mcfitz2/RoadNode/hardware/carrier/fab/lcsc_handfit.csv

LCSC Part Number | Quantity | Comment | Designator
C144395 | 3 | OBD pigtail | J1
C15771 | 3 | PESD1CAN | D4
C2905422 | 5 | Heltec JP4 | J4,J5
C2937110 | 3 | 1.5A hold | F1
C408468 | 3 | 15u | L1
C50950 | 3 | GT-U7 | J2
C53055672 | 3 | TERM 120R | JP1
C100114 | 3 | 2.54 mm jumper shunt | JP1 shunt
