mcfitz2/RoadNode/hardware/carrier/carrier.kicad_pcb

## KiCad design hardware/carrier/carrier.kicad_pcb (2026-10-16)

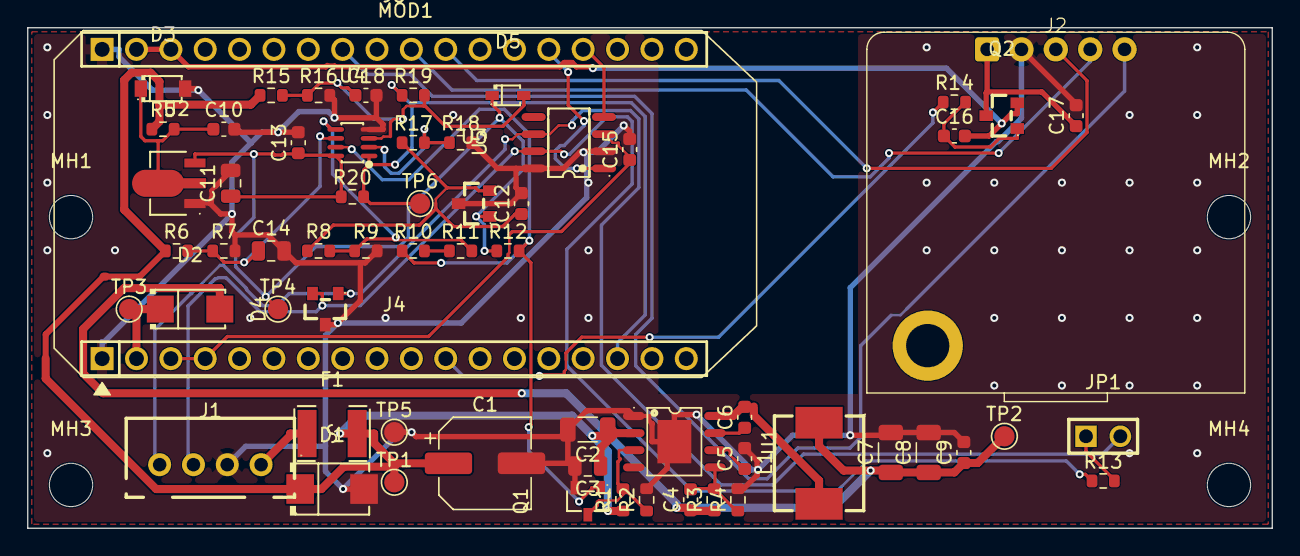
[picture p1: board carrier.kicad_pcb from above]

Board: 2 copper layers, 92.0 x 37.0 mm, 68 parts (0 on the bottom side), 33 nets.

Parts:
C1: 47u 50V; CP_Elec_6.3x7.7
C2: 10u 50V; C_1206_3216Metric
C3: 100n 100V; C_0805_2012Metric
C4: 10p C0G; C_0603_1608Metric
C5, C10, C17: 1u; C_0603_1608Metric
C6, C9, C12, C13, C15, C18: 100n; C_0603_1608Metric
C7, C8: 22u 25V; C_1206_3216Metric
C11, C14: 10u; C_0805_2012Metric
C16: 10n; C_0603_1608Metric
D1: SMBJ26A; SMB_L4.6-W3.6-LS5.3-RD
D2: SS34; SMA_L4.3-W2.6-LS5.2-RD
D3: BZT52C24; SOD-123_L2.7-W1.6-LS3.7-RD
D4: PESD1CAN; SOT-23_L2.9-W1.3-P1.90-LS2.4-BR
D5: 1N4148WS; SOD-323_L1.8-W1.3-LS2.5-RD
F1: 1.5A hold; F1812
J1: OBD pigtail; CONN-TH_B4B-XH-A-LF-SN
J2: GT-U7; GT-U7_THT
J4: Heltec JP4; HDR-TH_18P-P2.54-V-F
J5: Heltec JP5; HDR-TH_18P-P2.54-V-F
JP1: TERM 120R; HDR-TH_2P-P2.54-V-M_2
L1: 15u; IND-SMD_L7.3-W6.8
MH1, MH2, MH3, MH4: M3; MountingHole_3.2mm_M3
MOD1: Heltec WiFi LoRa 32 V4.3 (on sockets); Heltec_WiFi_LoRa32_V4
Q1: 2N7002; SOT-23-3_L2.9-W1.3-P1.90-LS2.4-BR
Q2: AO3401A; SOT-23_L2.9-W1.3-P1.90-LS2.4-BR
R1, R6: 3M; R_0603_1608Metric
R2, R7, R18: 750k; R_0603_1608Metric
R3, R12, R15, R20: 1M; R_0603_1608Metric
R4: 240k; R_0603_1608Metric
R5, R14: 10k; R_0603_1608Metric
R8: 510k; R_0603_1608Metric
R9, R10, R11, R19: 10M; R_0603_1608Metric
R13: 120; R_0603_1608Metric
R16: 220k; R_0603_1608Metric
R17: 47k; R_0603_1608Metric
TP1: VIN; TestPoint_Pad_D1.5mm
TP2: V5R; TestPoint_Pad_D1.5mm
TP3: H5V; TestPoint_Pad_D1.5mm
TP4: V3A; TestPoint_Pad_D1.5mm
TP5: GND; TestPoint_Pad_D1.5mm
TP6: WAKE; TestPoint_Pad_D1.5mm
U1: LMR36520ADDAR; POWERPAD-SO-8_L4.9-W3.9-P1.27-LS6.0-BL-EP
U2: HT7533-1; SOT-89-3_L4.5-W2.5-P1.50-LS4.2-BR
U3: REF3325 2.5V; SOT-23_L2.9-W1.3-P1.90-LS2.4-BR
U4: TLV7022DDFR; SOT-23-8_L2.9-W1.6-P0.65-LS2.8-BR
U5: SN65HVD230DR; SOIC-8_L4.9-W3.9-P1.27-LS6.0-BL

Connections:
3V3: C16.2, J5.2, J5.3, Q2.2
BOOT: C6.1, U1.7
BUCK_VCC: C5.1, U1.6
CANH: D4.2, J1.3, R13.1, U5.7
CANL: D4.1, J1.4, JP1.2, U5.6
CAN_RX: J5.15, U5.4
CAN_TERM: JP1.1, R13.2
CAN_TX: J5.14, U5.1
CAR_ON: J4.16, R19.1, R20.2, TP6.1, U4.1
EN: Q1.3, R1.2, R2.1, U1.3
FB: C4.2, R3.2, R4.1, U1.5
GND: C1.2, C2.2, C3.2, C5.2, C7.2, C8.2, C9.2, C10.2, C11.2, C12.2, C13.2, C14.2, C15.2, C17.2, C18.2, D1.2, D3.2, D4.3, J1.2, J2.2, J4.1, J5.1, Q1.2, R2.2, R4.2, R7.2, R9.2, R16.2, R18.2, TP5.1, U1.1, U1.9, U2.1, U3.3, U4.4, U5.2, U5.8
GNSS_EN_N: J4.11, R14.1
GNSS_G: C16.1, Q2.1, R14.2
GNSS_VCC: C17.1, J2.1, Q2.3
GPS_PPS: J2.5, J5.8
GPS_RXD: J2.3, J5.11
GPS_TXD: J2.4, J5.10
H_5V: D2.1, J4.2, TP3.1
SW: C6.2, L1.1, U1.8
UV_HYS: R10.2, R11.1
UV_LOW: Q1.1, R10.1, R12.2, U4.7
UV_REF: R8.2, R9.1, R11.2, U4.5
UV_TAP: C14.1, R6.2, R7.1, U4.6
V3A: C11.1, C13.1, D5.1, R12.1, R20.1, TP4.1, U2.3, U3.1, U4.8
V3A_IN: C10.1, D3.1, R5.2, U2.2
V5R: C4.1, C7.1, C8.1, C9.1, D2.2, L1.2, R3.1, TP2.1
VEXT: C15.1, J4.3, J4.4, U5.3
VIN: C1.1, C2.1, C3.1, D1.1, F1.2, R1.1, R5.1, R6.1, R15.1, TP1.1, U1.2
VREF: C12.1, R8.1, R17.1, U3.2
V_CAR: F1.1, J1.1
V_TAP: C18.1, D5.2, R15.2, R16.1, R19.2, U4.3
WAKE_REF: R17.2, R18.1, U4.2
