mcfitz2/RoadNode/src/vehicle/vehicle_state.h

#pragma once

#include <stddef.h>
#include <stdint.h>
#include <string.h>

#ifdef ARDUINO
#include "freertos/FreeRTOS.h"
#include "freertos/semphr.h"
#else
#include <mutex>
#endif

// Output-agnostic vehicle state (plan section 15). No MeshCore dependency:
// telemetry, serial output and any future UI all read from here.
namespace roadnode {
namespace vehicle {

enum DtcKind : uint8_t { DTC_STORED = 1, DTC_PENDING = 2, DTC_PERMANENT = 3 };

struct VehicleSnapshot {
  char vehicle_id[16] = {0};

  uint64_t total_mm = 0;
  uint64_t trip_mm = 0;
  bool trip_active = false;

  // Each live value is valid only if its has_* flag is set (never assume zero).
  bool has_speed = false;
  float speed_kmh = 0;
  bool has_rpm = false;
  float rpm = 0;
  bool has_battery = false;
  float battery_v = 0;

  // Slow-changing engine values (polled one PID at a time, see PollerConfig).
  bool has_coolant = false;
  float coolant_c = 0;
  bool has_load = false;
  float load_pct = 0;
  bool has_intake = false;
  float intake_c = 0;
  bool has_fuel = false;
  float fuel_pct = 0;

  // Last successful DTC read (modes 03/07/0A merged). Kept while OBD is briefly
  // lost; has_dtcs stays false until the first successful read.
  static constexpr size_t MAX_DTCS = 12;
  bool has_dtcs = false;
  uint16_t dtc_total = 0;          // codes the ECU reported, may exceed MAX_DTCS
  uint8_t dtc_count = 0;           // entries filled below
  uint16_t dtc_raw[MAX_DTCS] = {0};
  uint8_t dtc_kind[MAX_DTCS] = {0};  // DTC_STORED/PENDING/PERMANENT

  bool vehicle_active = false;  // CAN bus traffic seen recently
  bool engine_running = false;
  bool obd_connected = false;   // ECU answering requests

  // Milliseconds on the node's clock; 0 with the matching ever_* flag clear = never.
  bool ever_can_activity = false;
  uint32_t last_can_activity_ms = 0;
  bool ever_obd_response = false;
  uint32_t last_obd_response_ms = 0;
};

// Single writer (OBD poller) publishes complete snapshots; any number of
// readers copy them. Readers never see a half-updated snapshot.
class VehicleTelemetry {
public:
  VehicleTelemetry() {
#ifdef ARDUINO
    _mutex = xSemaphoreCreateMutex();
#endif
  }
  VehicleTelemetry(const VehicleTelemetry&) = delete;
  VehicleTelemetry& operator=(const VehicleTelemetry&) = delete;

  void publish(const VehicleSnapshot& s) {
    lock();
    _snap = s;
    unlock();
  }

  VehicleSnapshot snapshot() const {
    lock();
    VehicleSnapshot copy = _snap;
    unlock();
    return copy;
  }

private:
#ifdef ARDUINO
  void lock() const { xSemaphoreTake(_mutex, portMAX_DELAY); }
  void unlock() const { xSemaphoreGive(_mutex); }
  SemaphoreHandle_t _mutex;
#else
  void lock() const { _mutex.lock(); }
  void unlock() const { _mutex.unlock(); }
  mutable std::mutex _mutex;
#endif
  VehicleSnapshot _snap;
};

}  // namespace vehicle
}  // namespace roadnode
