mcfitz2/RoadNode/src/telemetry/vehicle_lpp.h

#pragma once

#include <stddef.h>
#include <stdint.h>

#include "vehicle/vehicle_state.h"

// Vehicle telemetry as Cayenne LPP (spec: docs/telemetry.md, issue #31).
// Header-only and templated on the LPP writer, so it has no MeshCore or
// CayenneLPP dependency: firmware instantiates it with CayenneLPP, host tests
// with a model of the wire format. Location is deliberately never encoded (#51).
namespace roadnode {
namespace telemetry {

// Channel 1 is MeshCore's own (device battery, GPS). Vehicle data starts at 2.
constexpr uint8_t CH_TOTAL_DISTANCE = 2;   // LPP generic sensor, units of 0.1 km
constexpr uint8_t CH_TRIP_DISTANCE = 3;    // LPP distance, metres
constexpr uint8_t CH_SPEED = 4;            // LPP analog input, km/h
constexpr uint8_t CH_STATE = 6;            // LPP digital input, bit flags
constexpr uint8_t CH_VEHICLE_BATTERY = 7;  // LPP voltage, volts
// VIN: 17 characters, 6 bits each, 4 per LPP generic sensor (24 bits, exact
// through a float). Channels 18-22; 8-17 were retired in PROJ-680.
constexpr uint8_t CH_VIN_FIRST = 18;
constexpr uint8_t VIN_CHANNELS = 5;

constexpr uint8_t STATE_VEHICLE_ACTIVE = 1 << 0;
constexpr uint8_t STATE_ENGINE_RUNNING = 1 << 1;
constexpr uint8_t STATE_TRIP_ACTIVE = 1 << 2;
constexpr uint8_t STATE_OBD_CONNECTED = 1 << 3;

// LPP encodes value * multiplier into a uint32 from a float. A float holds
// integers exactly up to 2^24, so the total is capped there (1.6 million km).
constexpr uint32_t TOTAL_UNIT_MM = 100000;
constexpr uint32_t TOTAL_MAX_UNITS = 16777216;
// LPP distance is 0.001 m in 32 bits: 4,294,967 m. Stay under it.
constexpr uint32_t TRIP_MAX_M = 4294000;

// VIN character codes: 0 = none, '0'-'9' = 1-10, 'A'-'Z' = 11-36.
inline uint32_t vinCharCode(char c) {
  if (c >= '0' && c <= '9') return (uint32_t)(c - '0') + 1;
  if (c >= 'A' && c <= 'Z') return (uint32_t)(c - 'A') + 11;
  return 0;
}

inline char vinCodeChar(uint32_t code) {
  if (code >= 1 && code <= 10) return (char)('0' + code - 1);
  if (code >= 11 && code <= 36) return (char)('A' + code - 11);
  return 0;
}

// Packs a 17-character VIN into VIN_CHANNELS 24-bit values, first character in
// the high bits. False (nothing written) if the VIN is missing or not 0-9/A-Z.
inline bool packVin(const char* vin, uint32_t out[VIN_CHANNELS]) {
  for (int g = 0; g < VIN_CHANNELS; g++) out[g] = 0;
  for (int i = 0; i < 17; i++) {
    uint32_t code = vinCharCode(vin[i]);
    if (code == 0) return false;
    out[i / 4] |= code << (18 - 6 * (i % 4));
  }
  return vin[17] == 0;
}

// Fields without a fresh value are omitted, never sent as zero. Total, trip
// and state are always present; the VIN only once one has been read.
template <class Lpp>
void encodeVehicle(const vehicle::VehicleSnapshot& s, Lpp& lpp) {
  uint64_t units = s.total_mm / TOTAL_UNIT_MM;
  if (units > TOTAL_MAX_UNITS) units = TOTAL_MAX_UNITS;
  lpp.addGenericSensor(CH_TOTAL_DISTANCE, (float)units);

  float trip_m = (float)(s.trip_mm / 1000.0);
  if (trip_m > (float)TRIP_MAX_M) trip_m = (float)TRIP_MAX_M;
  lpp.addDistance(CH_TRIP_DISTANCE, trip_m);

  if (s.has_speed) lpp.addAnalogInput(CH_SPEED, s.speed_kmh);

  uint8_t state = 0;
  if (s.vehicle_active) state |= STATE_VEHICLE_ACTIVE;
  if (s.engine_running) state |= STATE_ENGINE_RUNNING;
  if (s.trip_active) state |= STATE_TRIP_ACTIVE;
  if (s.obd_connected) state |= STATE_OBD_CONNECTED;
  lpp.addDigitalInput(CH_STATE, state);

  if (s.has_battery) lpp.addVoltage(CH_VEHICLE_BATTERY, s.battery_v);

  uint32_t vin[VIN_CHANNELS];
  if (packVin(s.vin, vin)) {
    for (int g = 0; g < VIN_CHANNELS; g++) lpp.addGenericSensor(CH_VIN_FIRST + g, (float)vin[g]);
  }
}

struct DecodedVehicle {
  bool has_total = false;
  double total_km = 0;
  bool has_trip = false;
  double trip_m = 0;
  bool has_speed = false;
  double speed_kmh = 0;
  bool has_state = false;
  uint8_t state = 0;
  bool has_battery = false;
  double battery_v = 0;
  bool has_vin = false;  // all five VIN channels present and valid
  char vin[18] = {0};
};

// Walks an LPP buffer and picks out the vehicle channels, skipping other
// channels (MeshCore's channel 1). Returns false on a truncated buffer or an
// LPP type this decoder does not know the size of.
inline bool decodeVehicle(const uint8_t* buf, size_t len, DecodedVehicle& out) {
  uint32_t vin[VIN_CHANNELS] = {0};
  uint8_t vin_seen = 0;
  size_t i = 0;
  while (i + 2 <= len) {
    uint8_t ch = buf[i], type = buf[i + 1];
    size_t size;
    switch (type) {
      case 0: case 1: case 102: case 120: case 142: size = 1; break;
      case 2: case 3: case 101: case 103: case 115: case 116: case 117: case 121: case 125: case 128: case 132:
        size = 2;
        break;
      case 100: case 118: case 130: case 131: case 133: size = 4; break;
      case 113: case 134: size = 6; break;
      case 136: size = 9; break;
      default: return false;
    }
    if (i + 2 + size > len) return false;
    const uint8_t* p = buf + i + 2;
    uint32_t u = 0;
    for (size_t k = 0; k < size && k < 4; k++) u = (u << 8) | p[k];

    if (ch == CH_TOTAL_DISTANCE && type == 100) {
      out.has_total = true;
      out.total_km = u / 10.0;
    } else if (ch == CH_TRIP_DISTANCE && type == 130) {
      out.has_trip = true;
      out.trip_m = u / 1000.0;
    } else if (ch == CH_SPEED && type == 2) {
      out.has_speed = true;
      out.speed_kmh = (int16_t)(uint16_t)u / 100.0;
    } else if (ch == CH_STATE && type == 0) {
      out.has_state = true;
      out.state = (uint8_t)u;
    } else if (ch == CH_VEHICLE_BATTERY && type == 116) {
      out.has_battery = true;
      out.battery_v = u / 100.0;
    } else if (ch >= CH_VIN_FIRST && ch < CH_VIN_FIRST + VIN_CHANNELS && type == 100) {
      vin[ch - CH_VIN_FIRST] = u;
      vin_seen |= 1 << (ch - CH_VIN_FIRST);
    }
    i += 2 + size;
  }
  if (vin_seen == (1 << VIN_CHANNELS) - 1) {
    out.has_vin = true;
    for (int k = 0; k < 17; k++) {
      out.vin[k] = vinCodeChar((vin[k / 4] >> (18 - 6 * (k % 4))) & 0x3F);
      if (out.vin[k] == 0) out.has_vin = false;
    }
    out.vin[17] = 0;
    if (!out.has_vin) out.vin[0] = 0;
  }
  return i == len;
}

}  // namespace telemetry
}  // namespace roadnode
