mcfitz2/RoadNode/src/ecusim/ecu_commands.cpp

#include "ecu_commands.h"

#include <stdio.h>
#include <stdlib.h>
#include <string.h>

namespace roadnode {
namespace ecusim {

static bool isOn(const char* s) { return s && strcmp(s, "on") == 0; }

bool handleEcuCommand(EcuSim& ecu, char* line, char* reply, size_t n) {
  EcuScenario& sc = ecu.scenario();
  char* save = nullptr;
  char* cmd = strtok_r(line, " \t", &save);
  char* a = strtok_r(nullptr, " \t", &save);
  if (!cmd) return false;
  reply[0] = 0;

  if (strcmp(cmd, "status") == 0) {
    snprintf(reply, n, "cycle=%s speed=%.0f rpm=%.0f vin=%s silent=%s refuse=%s delay=%lums pending=%u corrupt=%u ignore=0x%lX req=%lu forbidden=%lu dist=%.0fm",
             sc.drive_cycle ? "on" : "off", sc.speed_kmh, sc.rpm, sc.vin_supported ? sc.vin : "none",
             sc.silent ? "on" : "off", sc.refuse ? "on" : "off", (unsigned long)sc.reply_delay_ms, (unsigned)sc.pending_frames,
             (unsigned)sc.corrupt, (unsigned long)sc.ignore_modes, (unsigned long)ecu.requests(),
             (unsigned long)ecu.forbiddenRequests(), ecu.distanceM());
    return true;
  }
  if (strcmp(cmd, "cycle") == 0 && a) {
    sc.drive_cycle = isOn(a);
    if (sc.drive_cycle) ecu.resetDistance();
    snprintf(reply, n, "OK cycle %s", sc.drive_cycle ? "on" : "off");
    return true;
  }
  if (strcmp(cmd, "delay") == 0 && a) {
    sc.reply_delay_ms = (uint32_t)strtoul(a, nullptr, 10);
    snprintf(reply, n, "OK delay %lu ms", (unsigned long)sc.reply_delay_ms);
    return true;
  }
  if (strcmp(cmd, "pending") == 0 && a) {
    unsigned long k = strtoul(a, nullptr, 10);
    if (k > 8) return false;
    sc.pending_frames = (uint8_t)k;
    snprintf(reply, n, "OK pending %lu", k);
    return true;
  }
  if (strcmp(cmd, "corrupt") == 0 && a) {
    if (strcmp(a, "none") == 0) sc.corrupt = Corrupt::None;
    else if (strcmp(a, "short") == 0) sc.corrupt = Corrupt::ShortFrame;
    else if (strcmp(a, "skipcf") == 0) sc.corrupt = Corrupt::SkipConsecutive;
    else return false;
    snprintf(reply, n, "OK corrupt %s", a);
    return true;
  }
  if (strcmp(cmd, "silent") == 0 && a) {
    sc.silent = isOn(a);
    snprintf(reply, n, "OK silent %s", sc.silent ? "on" : "off");
    return true;
  }
  if (strcmp(cmd, "refuse") == 0 && a) {
    sc.refuse = isOn(a);
    snprintf(reply, n, "OK refuse %s", sc.refuse ? "on" : "off");
    return true;
  }
  struct Num {
    const char* name;
    float* field;
  } nums[] = {{"speed", &sc.speed_kmh}, {"rpm", &sc.rpm}, {"volts", &sc.module_volts}};
  for (const Num& x : nums) {
    if (strcmp(cmd, x.name) == 0 && a) {
      *x.field = (float)atof(a);
      snprintf(reply, n, "OK %s %.2f", x.name, *x.field);
      return true;
    }
  }
  if ((strcmp(cmd, "ignore") == 0 || strcmp(cmd, "unignore") == 0) && a) {
    unsigned long m = strtoul(a, nullptr, 16);
    if (m >= 32) return false;
    if (cmd[0] == 'i') sc.ignore_modes |= 1u << m;
    else sc.ignore_modes &= ~(1u << m);
    snprintf(reply, n, "OK ignore=0x%lX", (unsigned long)sc.ignore_modes);
    return true;
  }
  if (strcmp(cmd, "vin") == 0 && a) {
    if (strcmp(a, "none") == 0) {
      sc.vin_supported = false;
    } else if (strlen(a) == 17) {
      memcpy(sc.vin, a, 18);
      sc.vin_supported = true;
    } else {
      return false;
    }
    snprintf(reply, n, "OK vin %s", sc.vin_supported ? sc.vin : "none");
    return true;
  }
  return false;
}

}  // namespace ecusim
}  // namespace roadnode
