mcfitz2/RoadNode/src/telemetry/meshcore_telemetry.h

#pragma once

// The only RoadNode module allowed to include MeshCore headers (plan sections 6, 26).
#include <helpers/SensorManager.h>
#include <helpers/sensors/EnvironmentSensorManager.h>

namespace roadnode {

// Stock EnvironmentSensorManager plus vehicle telemetry from VehicleRuntime.
// MeshCore only reads the latest snapshot; the vehicle stack runs without it.
class RoadNodeSensorManager : public EnvironmentSensorManager {
public:
#if ENV_INCLUDE_GPS
  explicit RoadNodeSensorManager(LocationProvider& location) : EnvironmentSensorManager(location) {}
#else
  RoadNodeSensorManager() {}
#endif

  bool begin() override;
  bool querySensors(uint8_t requester_permissions, CayenneLPP& telemetry) override;
#if ENV_INCLUDE_GPS
  void loop() override;
  // True once a GNSS fix has been seen this boot, i.e. MeshCore has set the RTC from GPS time.
  bool clockFromGps() const { return _clock_from_gps; }

private:
  bool _clock_from_gps = false;
#endif
};

}  // namespace roadnode
