mcfitz2/RoadNode/src/vehicle/odometer_commands.h

#pragma once

#include <stdint.h>

#include "storage/kv_store.h"

// Admin commands for the device odometer (the car's own odometer cannot be read, so the device
// value drifts and needs resyncing by hand). MeshCore-free; the firmware passes an adapter that
// takes the vehicle task's lock.
namespace roadnode {
namespace vehicle {

constexpr uint32_t ODOMETER_MILES_MAX = 1000000;

class OdometerControl {
public:
  virtual ~OdometerControl() {}
  // False if the odometer could not be read (vehicle task busy).
  virtual bool read(uint64_t& total_mm) = 0;
  // Replace the odometer and persist it. False if busy or the write failed (old value kept).
  virtual bool setTotalMm(uint64_t total_mm) = 0;
  // Distance calibration in basis points (10000 = 100%). False if busy, out of range or not saved
  // (old value kept).
  virtual bool scaleBp(uint32_t& bp) = 0;
  virtual bool setScaleBp(uint32_t bp) = 0;
  // Unix time stamped on the last trip end; 0 if no trip has ended yet or the clock was unset
  // when one did. False if the value could not be read (vehicle task busy).
  virtual bool lastTripTimestamp(uint32_t& unix_seconds) = 0;
};

// Persistence of the calibration (KV key "odo_scale"). Load returns false and leaves bp alone when
// the key is missing or holds a value outside Mileage::SCALE_MIN_BP..SCALE_MAX_BP.
bool loadOdoScale(storage::KvStore& kv, uint32_t& bp);
bool saveOdoScale(storage::KvStore& kv, uint32_t bp);

// Percent with up to two decimals, 80 to 120, as basis points. Exposed for tests.
bool parsePercentBp(const char* s, uint32_t& bp);

// "odo" (show), "odo set <miles>" (miles with at most one decimal, 0 to 1,000,000),
// "odo scale [<percent>]" (show / set the calibration, 80 to 120 with up to two decimals) and
// "odo trip" (show the last trip-end time as UTC, for checking that GPS time reached the record).
// Returns true if the command was recognised; reply gets a short text.
bool handleOdometerCommand(OdometerControl& odo, const char* command, char* reply);

// Exposed for tests. Tenths of a mile <-> millimetres, integer math, rounded to nearest.
uint64_t milesTenthsToMm(uint32_t tenths);
uint32_t mmToMilesTenths(uint64_t mm);

}  // namespace vehicle
}  // namespace roadnode
