mcfitz2/RoadNode/src/telemetry/variant/target.cpp

// Derived from MeshCore (MIT, see THIRD_PARTY_NOTICES.md).
// RoadNode copy of vendor/MeshCore/variants/heltec_v4/target.cpp. Only the types of
// `sensors` and `board` differ. Re-diff against the vendor file on every MeshCore bump.
#include <Arduino.h>
#include "target.h"

roadnode::RoadNodeBoard board;

#if defined(P_LORA_SCLK)
  static SPIClass spi;
  RADIO_CLASS radio = new Module(P_LORA_NSS, P_LORA_DIO_1, P_LORA_RESET, P_LORA_BUSY, spi);
#else
  RADIO_CLASS radio = new Module(P_LORA_NSS, P_LORA_DIO_1, P_LORA_RESET, P_LORA_BUSY);
#endif

WRAPPER_CLASS radio_driver(radio, board);

ESP32RTCClock fallback_clock;
AutoDiscoverRTCClock rtc_clock(fallback_clock);

#if ENV_INCLUDE_GPS
  #include <helpers/sensors/MicroNMEALocationProvider.h>
  MicroNMEALocationProvider nmea = MicroNMEALocationProvider(Serial1, &rtc_clock);
  roadnode::RoadNodeSensorManager sensors = roadnode::RoadNodeSensorManager(nmea);
#else
  roadnode::RoadNodeSensorManager sensors;
#endif

#ifdef DISPLAY_CLASS
  DISPLAY_CLASS display(NULL);
  MomentaryButton user_btn(PIN_USER_BTN, 1000, true);
#endif

bool radio_init() {
  fallback_clock.begin();
  rtc_clock.begin(Wire);
  
#if defined(P_LORA_SCLK)
  return radio.std_init(&spi);
#else
  return radio.std_init();
#endif
}

mesh::LocalIdentity radio_new_identity() {
  RadioNoiseListener rng(radio);
  return mesh::LocalIdentity(&rng);  // create new random identity
}
