mcfitz2/RoadNode/src/ecusim/ecu_sim.h

#pragma once

#include <stddef.h>
#include <stdint.h>

#include "obd/obd_manager.h"

// Simulated OBD-II ECU for bench testing (issue 59). Pure logic: frames in, frames out.
// No hardware, no MeshCore, so it is unit-tested on the host against the real ObdManager.
namespace roadnode {
namespace ecusim {

// Deliberately broken replies, to exercise the node's error handling.
enum class Corrupt : uint8_t {
  None,
  ShortFrame,       // first reply frame is shorter than its own length byte says (node: Malformed)
  SkipConsecutive,  // multi-frame reply loses its first consecutive frame (node: Malformed, sequence gap)
};

struct EcuScenario {
  // Mode 01 values. Overwritten every update() while drive_cycle is on (speed, rpm).
  float speed_kmh = 0;
  float rpm = 800;
  float module_volts = 13.8f;

  char vin[18] = "1HGCM82633A004352";
  bool vin_supported = true;

  bool silent = false;       // answers nothing at all (bus silence on the ECU side)
  bool refuse = false;       // answers every request negatively (a gateway after shutdown)
  uint32_t reply_delay_ms = 0;  // first reply frame is held back this long
  uint8_t pending_frames = 0;   // send this many "7F mode 78" (response pending) frames before the real reply
  Corrupt corrupt = Corrupt::None;
  uint32_t ignore_modes = 0; // bit n set: mode n is never answered
  bool drive_cycle = false;  // speed follows driveSpeedKmh()
};

class EcuSim {
public:
  static constexpr uint32_t FUNCTIONAL_REQUEST_ID = 0x7DF;
  static constexpr uint32_t PHYSICAL_REQUEST_ID = 0x7E0;
  static constexpr uint32_t RESPONSE_ID = 0x7E8;

  EcuScenario& scenario() { return _sc; }
  const EcuScenario& scenario() const { return _sc; }

  // Advances the drive cycle and integrates distance. Call at least every ~100 ms.
  void update(uint32_t now_ms);

  // Feed every frame seen on the bus. Responses are queued for nextFrame().
  void onFrame(const obd::CanFrame& f);
  bool nextFrame(obd::CanFrame& out);

  // Metres driven by the simulated speed since the drive cycle was switched on (known truth).
  double distanceM() const { return _distance_m; }
  void resetDistance() { _distance_m = 0; }

  // Speed at t seconds into the cycle: 10 s stopped, 20 s ramp to 60, 60 s cruise, 20 s ramp down, 20 s stopped.
  static float driveSpeedKmh(uint32_t cycle_ms);
  static constexpr uint32_t CYCLE_MS = 130000;

  uint32_t requests() const { return _requests; }
  // Requests for a mode outside 01/09 (e.g. 03 read codes, 04 clear codes). The node must never send one.
  uint32_t forbiddenRequests() const { return _forbidden; }
  uint8_t lastForbiddenMode() const { return _last_forbidden; }

private:
  static constexpr size_t QUEUE = 16;
  static constexpr size_t MAX_PAYLOAD = 64;

  void handleRequest(const uint8_t* d, uint8_t n);
  void respond(const uint8_t* payload, size_t len);
  void negative(uint8_t mode, uint8_t nrc);
  void mode01(uint8_t pid);
  void mode09(uint8_t pid);
  void push(const obd::CanFrame& f, uint32_t delay_ms = 0);
  void sendConsecutive();

  EcuScenario _sc;
  obd::CanFrame _q[QUEUE];
  uint32_t _ready[QUEUE] = {0};  // time each queued frame may be released
  size_t _qh = 0, _qn = 0;

  // Multi-frame response waiting for the flow-control frame.
  uint8_t _pend[MAX_PAYLOAD];
  size_t _pend_len = 0, _pend_sent = 0;
  bool _awaiting_fc = false;
  uint8_t _pend_seq = 1;

  uint32_t _last_ms = 0;
  uint32_t _cycle_ms = 0;
  bool _have_last = false;
  double _distance_m = 0;
  uint32_t _requests = 0, _forbidden = 0;
  uint8_t _last_forbidden = 0;
};

}  // namespace ecusim
}  // namespace roadnode
