mcfitz2/RoadNode/(commit log)

2026-10-06 Add project plan and MeshCore build/telemetry investigation
    Documents the PlatformIO/Arduino decision, MeshCore as an unmodified
    submodule, the LPP telemetry model, and Heltec V4 pin conflicts.
2026-10-06 Add MeshCore submodule, PlatformIO env, module scaffold, CI
    MeshCore is pinned at a366955c in vendor/MeshCore and is not modified.
    Root platformio.ini points src_dir at the submodule so its build filters
    resolve unchanged. RoadNode modules from plan section 23 are stubs.
    [meshcore_telemetry.cpp, meshcore_telemetry.h, mileage.cpp, mileage.h]
2026-10-06 Target Heltec V4.3 without OLED; add README
    Env now extends Heltec_lora32_v4 (no display, no I2C flags on GPIO3/4).
    README documents CAN wiring, board pin usage and design principles.
2026-10-06 Implement TWAI init in can_manager
    begin()/end() wrap the legacy twai driver with selectable mode
    (loopback/listen-only/normal), bitrate and pins (default GPIO3/4).
    Driver errors are returned as Result and logged.
2026-10-06 Add CAN sniffer and loopback self-test firmware
    can_manager gains transmit/receive/status (transmit refused in
    listen-only mode). New MeshCore-independent envs: heltec_v4_cansniffer
    (listen-only serial frame logger) and heltec_v4_canloopback (self-test).
    CI builds all three envs.
2026-10-06 Add mileage engine and trip state machine with host tests
    Mileage integrates OBD speed into uint64 millimeters with trapezoid
    averaging and an exact carried remainder (no drift), gap skipping and
    wrap-safe timing. Trip is a pure state machine with an inactivity timeout.
    Host unit tests (Unity, 23 cases) run with `pio test -d host` and in CI.
    [mileage.cpp, mileage.h, trip.cpp, trip.h]
2026-10-06 Add power-loss-safe mileage storage and checkpoint policy
    A/B slot records with CRC-32 and wrap-safe sequence numbers, a SlotStore
    interface with an NVS backend for the device, and a checkpoint policy
    (0.5 mile or 2 minutes, only when distance changed). Host tests inject a
    torn write at every byte offset. Wear estimate in docs/storage.md.
2026-10-06 Add MileageTracker: restore, trip-end/shutdown checkpoints, retry on write failure
    Combines Mileage, Trip, CheckpointPolicy and VehicleStorage with no MeshCore
    dependency. Host-tested with a fault-injecting fake store (reboot, power cut,
    OBD link loss, failed writes).
    [mileage_tracker.cpp, mileage_tracker.h]
2026-10-06 Add OBD layer: ISO-TP, PID decoders, discovery, VIN, profiles
    ObdManager talks to a CanBus interface (host-tested with a scripted fake bus);
    ObdCanBus adapts the TWAI driver. Transmission is gated off by default.
2026-10-06 Add VehicleTelemetry, VehiclePoller and OBD monitor firmware
    Poller drives ObdManager, feeds MileageTracker and publishes thread-safe
    snapshots. Handles no CAN, OBD loss, malformed/negative responses, unsupported
    PIDs and bus-off recovery (rate limited). Fixes CapabilityTable range
    indexing and treats ranges past the last discovered one as unsupported.
    heltec_v4_obdmonitor env runs the stack without MeshCore.
    [main.cpp, mileage_tracker.h]
2026-10-06 Add vehicle LPP telemetry, VehicleRuntime and MeshCore sensor integration
    Define the vehicle telemetry format (docs/telemetry.md) as Cayenne LPP with
    encode/decode and host tests. Add VehicleRuntime (CAN/OBD/mileage in a core-0
    task, MeshCore-free) and RoadNodeSensorManager, wired in through RoadNode-owned
    copies of the heltec_v4 target files so the submodule stays unmodified.
    Location is never reported. Move I2C off the CAN pins (GPIO17/18).
2026-10-06 Report GPS in telemetry to authenticated clients only
    Stop stripping TELEM_PERM_LOCATION. Telemetry replies are encrypted and
    answered only for ACL clients; adverts carry fixed prefs, not live GPS.
    [meshcore_telemetry.cpp]
2026-10-06 Add engine-start and parked alerts with position
    Replace the vendor simple_sensor main.cpp with a RoadNode copy that raises
    encrypted alerts to opted-in ACL clients. Condition logic is MeshCore-free
    and host tested.
    [alert_logic.h, main.cpp]
2026-10-06 Default periodic alert to 5 minutes
    Clamp the hold window to half the interval so the condition always releases
    and re-arms before the next report is due.
2026-10-06 Add read-only DTC reads: Mode 03, 07 and 0A
    Decode stored, pending and permanent codes (P/C/B/U) from single and
    multi-frame responses, with and without the CAN count byte. Negative
    responses 0x11/0x12 report Unsupported. Mode 04 (clear) is not implemented.
2026-10-06 Defer DTC reads while the vehicle is moving
    DTC reads block the poll task for several request timeouts, stretching the
    gap between speed samples used for distance. Read only when stopped, with a
    forced read after 10 minutes of continuous motion.
2026-10-06 Persist vehicle ID and store the VIN locally
    Short vehicle ID is configurable (admin vid / vid set) and persisted in NVS.
    VIN is read once per boot while stopped, stored on first read, flagged on
    mismatch, and never placed in the snapshot, telemetry, alerts or replies.
    [identity_commands.cpp, identity_commands.h, main.cpp]
2026-10-06 Poll coolant, load, intake temp and fuel level slowly
    One PID per 2.5 s round-robin so speed sampling spacing is unchanged. Values
    go into the snapshot and LPP channels 10-13, omitted when unknown or stale.
2026-10-06 Make periodic alert interval configurable at runtime; document send policy
    Admin 'alert periodic <min>' persists in NVS (0 disables). Add a CI check that
    MeshCore-facing code never touches CAN frames, and an airtime estimate.
2026-10-06 Add GPS-derived distance, speed and heading as separate telemetry
    GpsTrack computes motion from MeshCore's location provider fixes at ~1 Hz and
    is independent of the OBD odometer. Channels 14-16 are appended and only sent
    with location permission. Enable GNSS at boot. Remove the unused gps_manager stub.
    [gps_track.cpp, gps_track.h, meshcore_telemetry.cpp, meshcore_telemetry.h, vehicle_lpp.h]
2026-10-07 Add RP2040 bench ECU simulator (issue 59, first cut)
    EcuSim answers OBD-II requests so the real node can be tested without a
    car: mode 01 discovery and PIDs, modes 03/07/0A DTCs (multi-frame with
    flow control), mode 09 VIN, negative responses, silent/ignored modes and
    a drive cycle with a known distance integral. It counts any request
    outside 01/03/07/09/0A so a stray mode 04 is caught.
    Logic is hardware-free and host tested against the real ObdManager.
    rp2040_ecusim targets the Adafruit Feather RP2040 CAN (MCP25625) and is
    built in CI. heltec_v4_roadnode excludes src/ecusim (own setup/loop).
    Not run on hardware; the MCP25625 crystal (16 MHz assumed) is unconfirmed.
    Fault injection beyond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
    [ecu_commands.cpp, ecu_commands.h, ecu_sim.cpp, ecu_sim.h, main.cpp]
2026-10-07 Add MIT LICENSE and MeshCore third-party notice
    LICENSE covers RoadNode code (MIT, per the issue 53 decision).
    THIRD_PARTY_NOTICES.md reproduces MeshCore's MIT notice for the
    submodule and the three files copied and modified from it
    (src/node/main.cpp, src/telemetry/variant/target.{h,cpp}), which also
    get a one-line pointer. README gains a License section.
    [main.cpp, target.cpp, target.h]
2026-10-07 Make VehicleIdentity::copyId seqlock use atomic ordering
    _ver was a plain uint32_t, so the reader had no acquire/release ordering
    against setId() and the compiler was free to hoist the loads. Use
    std::atomic with release stores in the writer and an acquire load plus
    fence in the reader. Adds a two-thread test that flips the ID between
    two values and checks no reader ever sees a mixed copy.
    [vehicle_identity.cpp, vehicle_identity.h]
2026-10-07 Checkpoint odometer on reboot/poweroff; feed GPS-set time to mileage
    #54: RoadNodeBoard overrides MeshCore's reboot()/powerOff() (used by the
    admin reboot/poweroff/shutdown/clkreboot commands) to call
    VehicleRuntime::shutdown() first. shutdown() now takes a mutex shared
    with the poll task so the tracker is never written from two tasks, and
    gives up after 2 s instead of racing. OTA and power loss are not covered.
    #55: once a GNSS fix has been seen this boot (RTC set from GPS), the
    60 s sensor read passes the RTC time to MileageTracker so
    last_trip_timestamp is populated. Before a fix it is left alone because
    a stock RTC holds an arbitrary value.
    Host tests unchanged (214 pass): the new code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
    [main.cpp, meshcore_telemetry.cpp, meshcore_telemetry.h, roadnode_board.h, target.cpp, target.h, vehicle_runtime.cpp, vehicle_runtime.h]
2026-10-07 CI: fail when a shadowed MeshCore file changes upstream
    scripts/check_vendor_drift.sh compares the git blob hash of each vendor
    file RoadNode shadows (simple_sensor/main.cpp, heltec_v4 target.h/.cpp)
    with scripts/vendor_baseline.txt, recorded when the RoadNode copies were
    last reconciled (MeshCore a366955c). A mismatch names the file and the
    git diff to run; --update records a new baseline after porting changes.
    Runs in CI before the build. docs/meshcore.md has the bump procedure.
    [target.cpp]
2026-10-07 ECU simulator: fault injection (reply delay, 0x78 pending, short frame, dropped consecutive frame)
    Adds delay/pending/corrupt serial commands and host tests that drive ObdManager
    through each fault. Bus-off cannot be forced from the simulator; documented.
    [ecu_commands.cpp, ecu_commands.h, ecu_sim.cpp, ecu_sim.h, main.cpp]
2026-10-07 OBD vs GPS trip distance comparison (#43)
    compareTrip() yields a GPS/OBD ratio per finished trip, invalid (not zero)
    for short trips or low GPS fix coverage. GpsTrack now tracks fix time per
    trip. The GPS side is frozen at the trip-end edge, logged as a serial line
    and exposed as telemetry channel 17 to location-permission requesters.
    [gps_track.cpp, gps_track.h, meshcore_telemetry.cpp, meshcore_telemetry.h, trip_compare.cpp]
2026-10-07 Persist last trip OBD/GPS comparison across reboots (#43)
    One NVS string (roadnode_cfg/trip_cmp) written at each trip end and loaded at
    boot; malformed values are ignored. Each trip replaces the previous result.
    [meshcore_telemetry.cpp, meshcore_telemetry.h, trip_compare.cpp, trip_compare.h]
2026-10-07 Odometer: GPS gap fill and 'odo set' resync command (#60)
    GPS distance is added to the odometer only while OBD speed is unavailable, so
    the two sources never count the same metres. 'odo' / 'odo set <miles>' admin
    commands show and resync the value; set persists at once and reverts if the
    write fails.
    [gps_track.cpp, gps_track.h, main.cpp, meshcore_telemetry.cpp, meshcore_telemetry.h, mileage.cpp, mileage.h, mileage_tracker.cpp]
2026-10-07 Forward other nodes' packets by default (set repeat off to disable)
    Default applied before MeshCore loads saved prefs, so a persisted
    'set repeat off' still wins. -D REPEAT_DEFAULT_ON=0 flips the default.
    [main.cpp]
2026-10-07 Odometer calibration (odo scale) and whole-stack host test against EcuSim
    odo scale <percent> (80-120) multiplies OBD and GPS-filled distance, persisted in NVS.
    test_stack runs ECU sim -> poller -> tracker -> storage and checks the odometer against exact simulated distance,
    bus unplug, reboot, power cut and the scale factor.
    [mileage.cpp, mileage.h, mileage_tracker.h, odometer_commands.cpp, odometer_commands.h, vehicle_runtime.cpp]
2026-10-07 CI: attach merged firmware image to GitHub releases on v* tags
2026-10-08 CAN: MCP2515 backend for the Adafruit PiCowbell CAN Bus, default in the Heltec envs
    The SN65HVD230 modules tried on the bench never drove or received. The PiCowbell
    (MCP2515 + TJA1051T/3, 16 MHz crystal, 3.3 V logic) brings its own transceiver, and
    two are on hand, so the Heltec envs now talk to it over a dedicated SPI bus
    (SCK 47, MISO 41, MOSI 48, CS 3, INT 4).
    - src/can/mcp2515.{h,cpp}: pure driver over an abstract SPI bus (timing, modes,
    filters, extended frames, TX abort, error counters), host tested against a fake chip.
    - src/can/can_mcp2515_backend.cpp: ESP32 backend behind the unchanged can:: API,
    INT-driven RX task feeding a queue. Selected by -D CAN_BACKEND_MCP2515; TWAI stays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
    [main.cpp, vehicle_runtime.cpp]
2026-10-08 Revert "CAN: MCP2515 backend for the Adafruit PiCowbell CAN Bus, default in the Heltec envs"
    This reverts commit 02ebbcc9d30a68c20ce9de7134aebda3950d7f5d.
    TWAI with an SN65HVD230 stays the default CAN path while replacement transceiver
    modules are tried. The MCP2515 work is kept on the mcp2515-picowbell branch and can
    be restored by merging it or reverting this commit.
    [main.cpp, vehicle_runtime.cpp]
2026-10-12 Alerts: also post to an optional private group channel
    Stock MeshCore apps show sensor nodes without a chat view, so the direct
    alerts are delivered and ACKed but never displayed. Each alert (started,
    moving, parked, DTC, battery) is now also flooded as a group text
    "<node name>: <text>" to a private channel, readable by every client that
    holds the channel secret.
    Admin commands: "alert channel <hex secret>" (32 or 64 hex chars,
    persisted in NVS), "alert channel" (status, never echoes the secret),
    "alert channel off" (erase). Channel posts fire once per rising edge and
    are not ACKed or retried; the existing direct alerts are unchanged.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
2026-10-13 docs: car test checklist for the first in-vehicle run
    Laptop setup, wiring and termination check, and the per-issue checks
    (#41, #17, #44, #60, #43, #55) that the bench cannot cover, plus the
    privacy rules for testing with a live GPS fix.
2026-10-15 Add 'odo trip' readout and a vehicle capability dump
    Two things a car test could not see before.
    last_trip_timestamp was persisted in the record and restored on boot, but
    nothing read it back, so the trip-end timestamp could only be host-tested
    and never confirmed on a device. Add `odo trip`, printing the stored stamp
    as UTC. It reports "none" when no trip has ended yet or the clock was
    unset when one did; note mileage_tracker.cpp only stamps when the clock is
    set, so a trip ending with an unset clock keeps the previous stamp and the
    command is worth reading before and after a drive.
    Supported PIDs could likewise only be inferred from which values stayed
    unread, which cannot distinguish "t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
2026-10-15 Descope DTCs, GPS gap fill, trip compare and extra PIDs (PROJ-680) (#61)
    Remove DTC reading and alerts, GPS distance gap fill, OBD/GPS trip
    comparison and the coolant/load/intake/fuel polls from the node, the
    telemetry encoder and the ECU simulator. Telemetry now carries channels
    2, 3, 4, 6 and 7 only. The node requests only modes 01 and 09; the
    simulator counts anything else as forbidden. Sim skipcf now drops the
    first consecutive frame so the two-frame VIN reply still shows a
    sequence gap.
    Kept: speed/RPM/module-voltage poll, VIN, GPS for alert position and
    the RTC. Obsolete tests deleted; docs and the car test checklist
    updated.
2026-10-15 Add OBD carrier board (KiCad) with voltage wake and logo (#62)
    KiCad design for the carrier that holds the Heltec V4.3, CAN transceiver,
    buck from OBD pin 16, NTC-gated cell charging and 2x 18650. circuit.py
    (SKiDL) is the source of truth; build_pcb.py places, tools/autoroute.py
    routes, tools/export_fab.py writes JLC gerbers, BOM and CPL into fab/.
    Engine-running wake (PROJ-595): VIN divider into a TLV7022 comparator,
    on at ~13.3 V and off at ~13.0 V, open drain to GPIO21 (the only free RTC
    pin; GPIO2/5/7 belong to the V4.3 LoRa front end). Thresholds and
    tolerance in sim/wake_thr.py.
    Silkscreen: RoadNode logo, author name and repo URL, drawn by
    build_pcb.py from lib/roadnode_logo.svg so r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
2026-10-16 Carrier: drop the battery, add a car-battery low-voltage cutoff (#63)
    Remove the 18650 cells, DW01A/8205A protection, per-cell PTCs, NTC
    charge gate and load switch. The node now runs only from the car.
    - Always-on 3.3 V rail (HT7533 behind 10k + 24 V zener) and a REF3325
    2.5 V reference keep both comparators working with the buck off.
    - TLV7022 half B is a low-voltage cutoff that pulls buck EN low via a
    2N7002: off below 11.6 V, on above 12.0 V nominal (worst case
    11.39-11.83 / 11.77-12.23 V), with a 6 s filter that rides through
    cranking. Clear of the measured 12.0 V key-on and 12.5 V resting
    voltages on the RAV4 and Maverick (sim/uvlo_thr.py).
    - Wake comparator (half A) now ref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
2026-10-16 Add VIN to telemetry; remove vehicle profiles (PROJ-682) (#64)
    VIN in telemetry:
    - VehicleSnapshot carries the stored VIN, copied from VehicleIdentity.
    - encodeVehicle packs the 17 characters 6 bits each into five LPP generic
    sensors on channels 18-22 (24 bits each, exact through LPP's float).
    Omitted until a VIN has been read; decodeVehicle reports it only when all
    five channels are present.
    - The VIN goes only in the encrypted, ACL-only telemetry reply, never in
    adverts or alerts. This reverses #34's device-only rule; identity comment,
    docs/telemetry.md and the poller guard test are updated.
    - Full vehicle record is 53 bytes (23 without the VIN), well under 180.
    Profiles removed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
2026-10-16 Deep sleep while parked, wake on CAR_ON (PROJ-596) (#65)
    RoadNode no longer repeats: it runs only from the car battery, the car is
    usually parked next to an existing repeater, and a moving node is a poor
    repeater. So once parked it sends the parked alert, checkpoints and deep
    sleeps until the carrier's CAR_ON line (GPIO21) goes high.
    - SleepPolicy (host-tested): sleep 2 min after parked (alert send window),
    or after 10 min idle without a trip; never while operating or CAR_ON high.
    - enterParkedSleep: save the odometer, power off the radio and PA, hold NSS
    and PA power, stop GPS, ext0 wake on CAR_ON high.
    - Log the wake cause at boot and every CAR_ON change.
    - Drop the repeat-on default;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
2026-10-16 Power the CAN transceiver from VEXT around TWAI (PROJ-685) (#66)
    The carrier powers the SN65HVD230 from Heltec VEXT, which
    HeltecV4Board::begin() switches off, so CAN never came up on the carrier.
    - RoadNodeBoard::begin() claims periph_power before sensors.begin()
    starts TWAI; sleep() stops CAN, releases VEXT and holds GPIO36 off
    through deep sleep. powerOff() goes through sleep() too.
    - VehicleRuntime::suspend(): checkpoint, stop TWAI and float GPIO3 so the
    unpowered transceiver is not fed through D. Keeps the poll lock.
    - Parked deep sleep uses board.sleep().
    - Sniffer, loopback and monitor switch VEXT on via can::powerOn().
    - Carrier comments no longer claim GPIO36 is active low.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
2026-10-16 Clear obd_connected when the ECU only answers negatively (PROJ-686) (#67)
    A negative response resets the consecutive-failure count (the ECU is
    alive), and obd_connected only cleared on that count. A gateway that
    answers every poll with 7F after shutdown therefore kept obd_connected
    true forever, and the parked alert, keyed to !obd_connected, never fired.
    obd_connected now also requires a fresh live value (speed, rpm or
    battery within value_stale_ms). Negative-response accounting is
    unchanged.
    - ECU sim: new `refuse on|off` scenario answers every mode 01/09
    request with NRC 0x22, for host tests and the bench.
    - Tests: poller all-negative clears the connection and recovers; stack
    test dr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
2026-10-16 Remove stock Li-ion battery alerts and history (PROJ-687) (#68)
    The carrier has no cell since #63, so the Heltec battery ADC reading is
    meaningless. Below 3.4 V the stock simple_sensor logic sent a high-priority
    "Battery is critical!" alert plus a channel post, possibly on every
    park/wake boot.
    - Drop the low/critical triggers and their edge flags from MyMesh.
    - Drop the 24 h battery TimeSeriesData; querySeriesData returns no series.
    - Record the deviation in the shadowed file's header comment; update
    docs/telemetry.md.
    Vehicle 12 V low-voltage alerting stays out of scope: the carrier's
    hardware cutoff covers it.
2026-10-16 Re-arm the VIN read on vin clear and lock the VIN across tasks (PROJ-689) (#70)
    `vin clear` forgot the stored VIN but the poller had already marked the
    read done for this boot, so the new vehicle's VIN was not read until a
    reboot. clearVin() now bumps a generation counter; the poller resets its
    VIN read state when the generation changes.
    The VIN is written from the poll task (onVinRead) and the admin command
    task (clearVin), and the poller copied it into the snapshot unlocked.
    VehicleIdentity now guards the VIN with a mutex; the poller copies it
    with copyVin().
    Tests: poller re-reads after clear and then stops; failed clear keeps
    the VIN and generation; a cross-thread copy never sees a tor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
2026-10-16 Fix stale docs: README power note, plan.md scope, anyFrameSeen comment (PROJ-690) (#71)
    - README: breadboard runs from USB with pin 16 unconnected; the carrier
    runs from pin 16 through fuse, TVS, buck and low-voltage cutoff, with
    no battery. The plan.md link now says it is the original plan. The
    layout line lists the real src/ dirs and says node/ also includes
    MeshCore headers.
    - plan.md: header listing what was superseded (DTCs, vehicle profiles,
    GPS and extra PIDs, Li-ion power).
    - obd_manager.h: anyFrameSeen() counts every received frame, before the
    responder-ID filter. Comment only, no behaviour change.
